Martin-Ansteensen/steppper-robot-arm/images/bearing_2.jpg

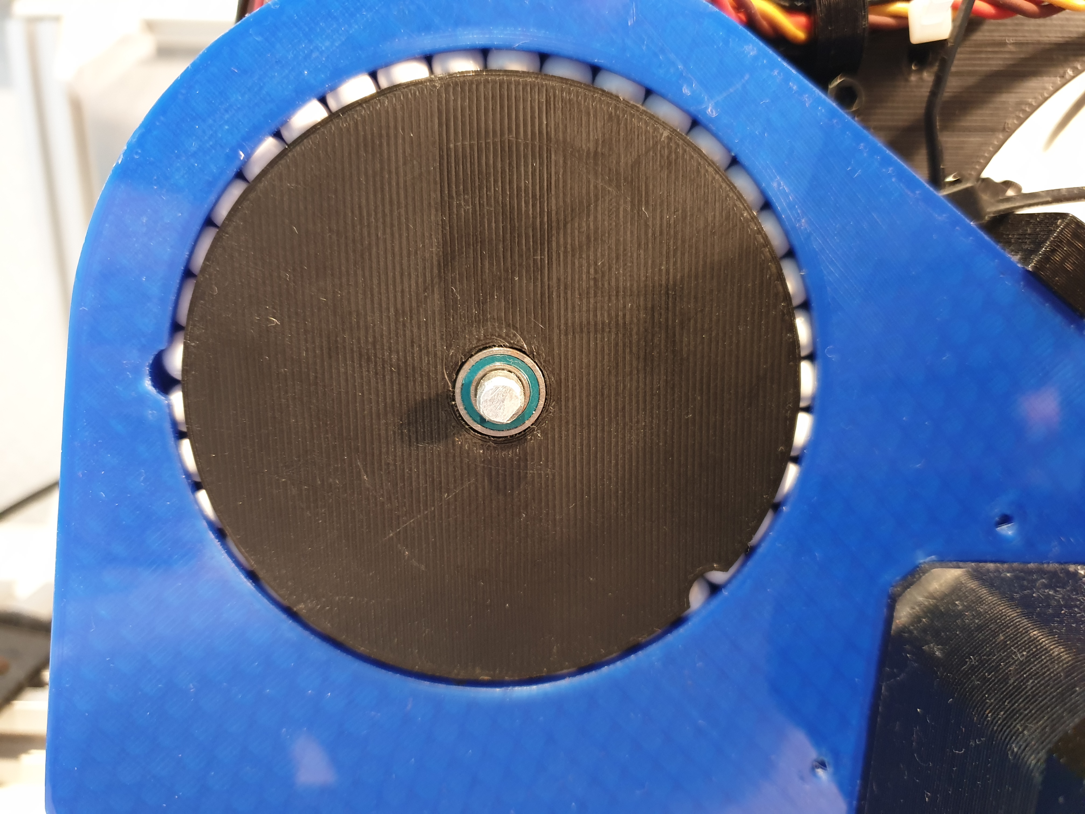
images/bearing_2.jpg
