Martin-Ansteensen/steppper-robot-arm/FinalVersion Drawing v4.pdf

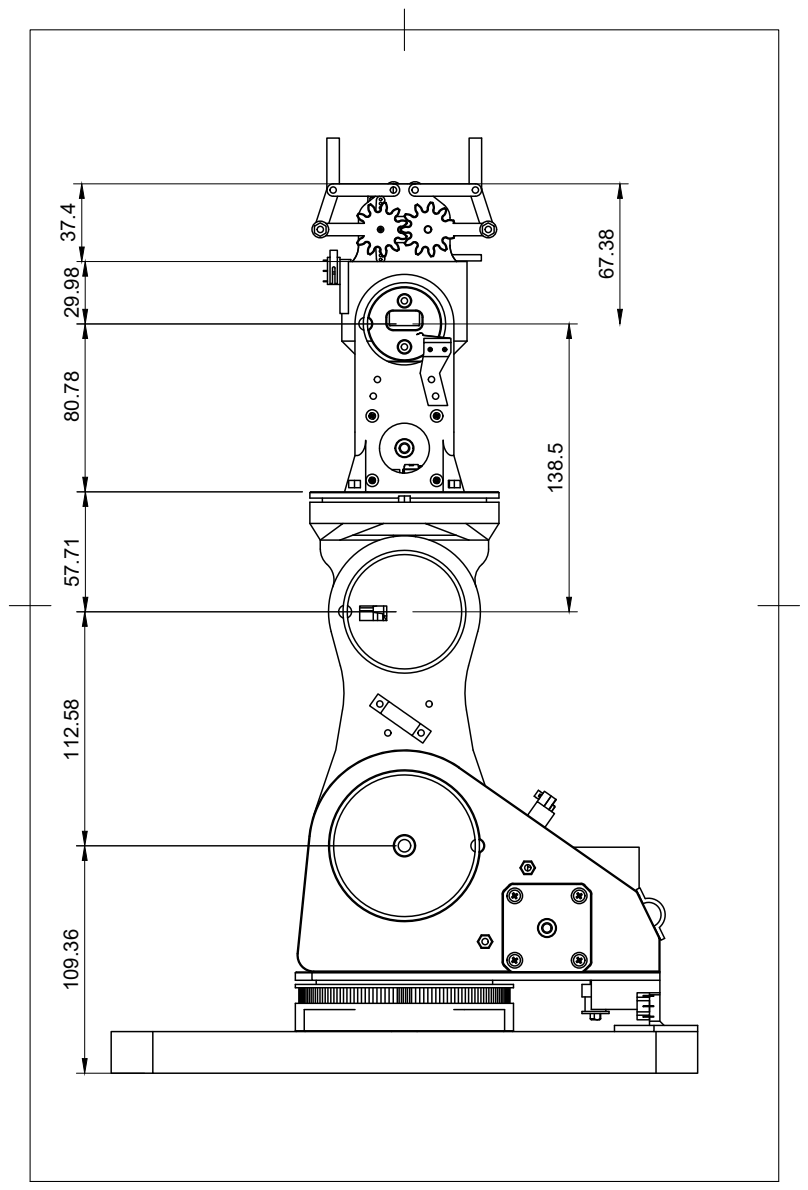
[picture p6: page 1]

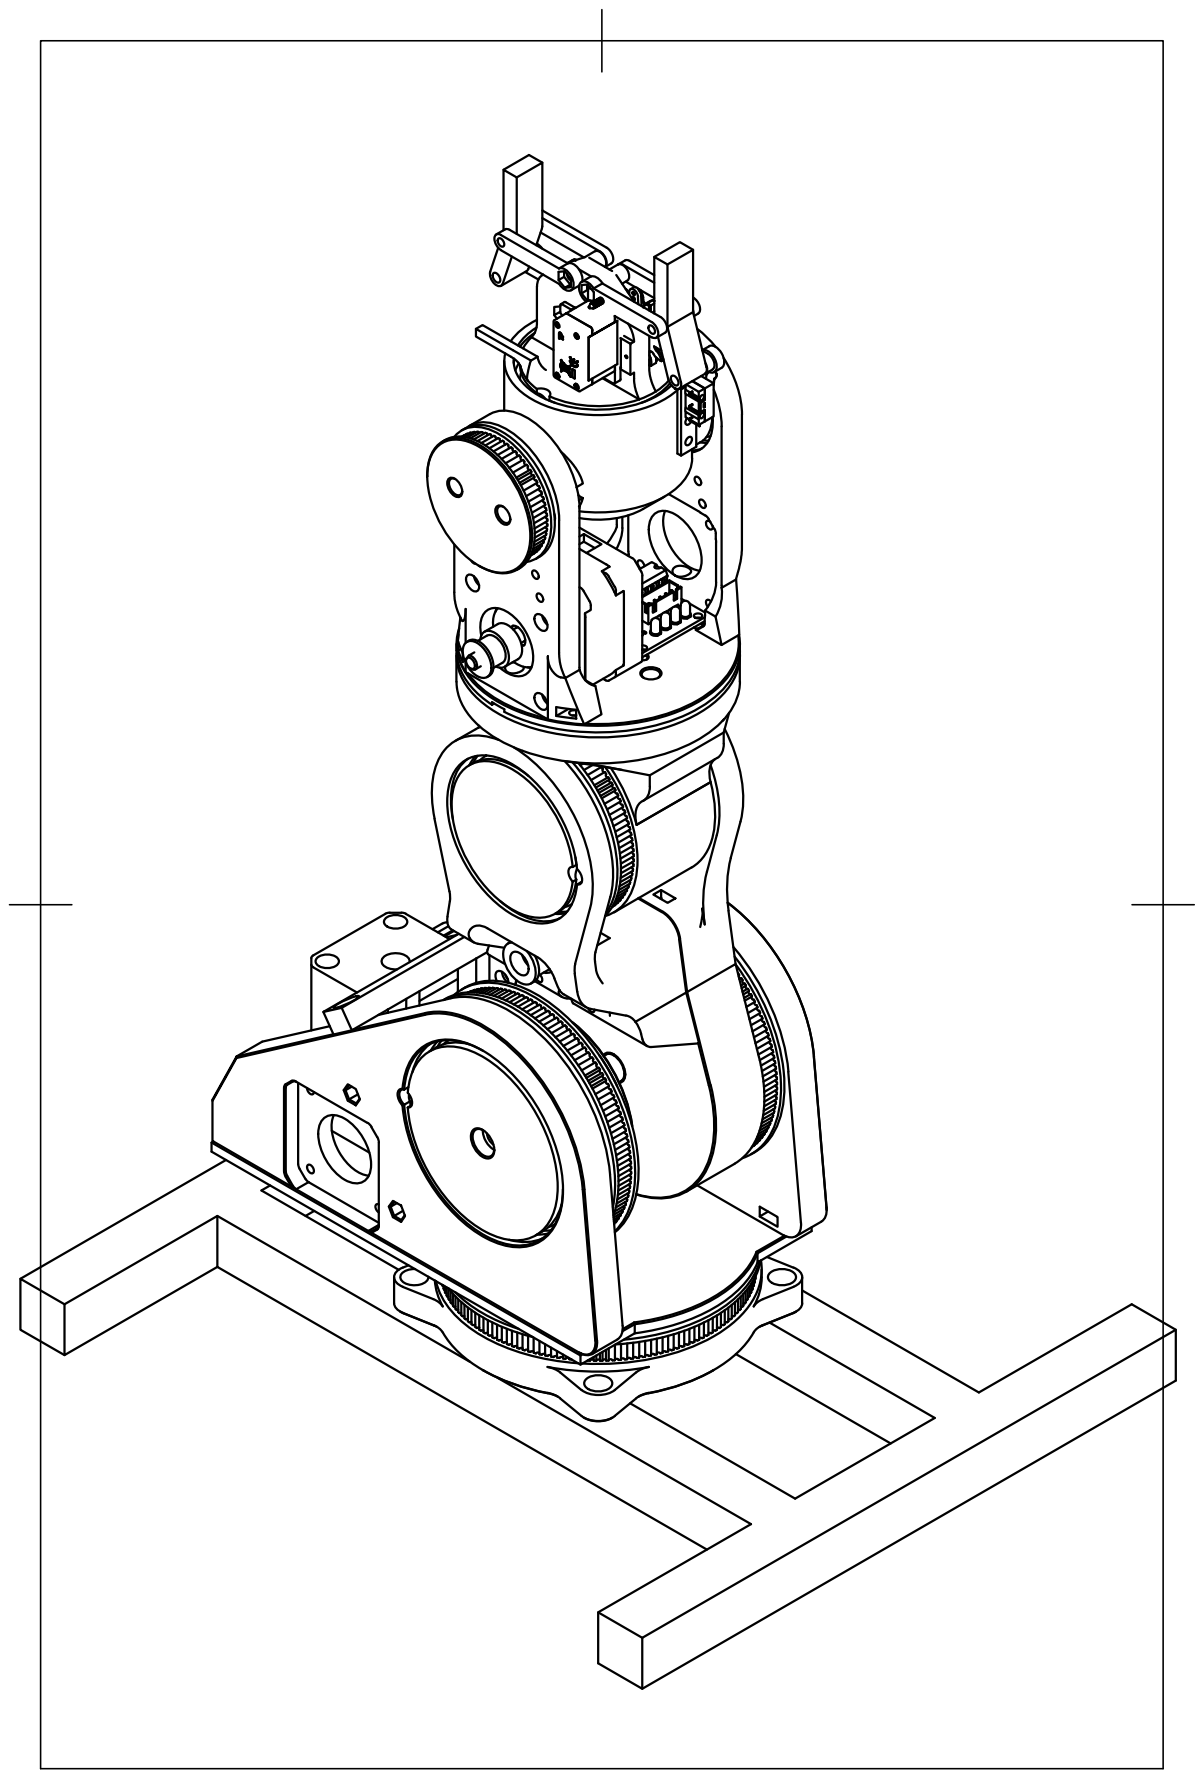
[picture p7: page 2]
