Martin-Ansteensen/steppper-robot-arm/RobotArmDrawing.pdf

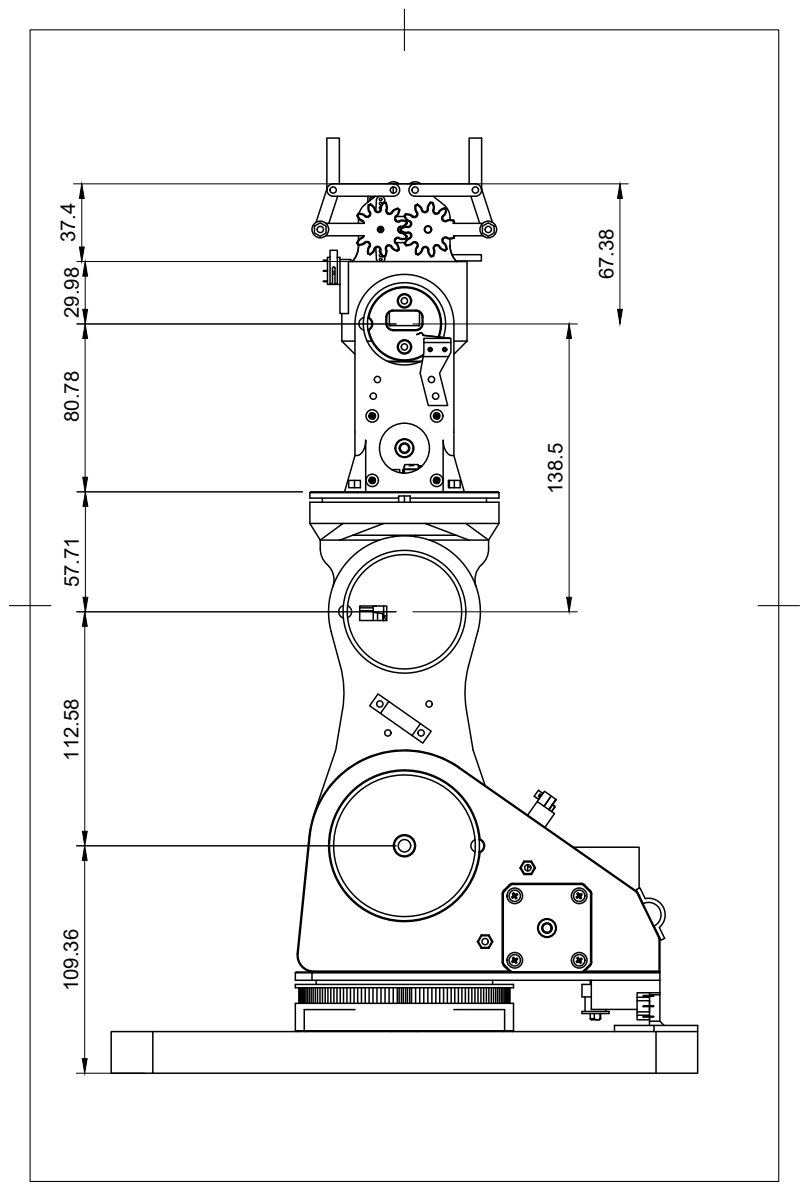
[picture p8: page 1]
