Martin-Ansteensen/steppper-robot-arm/kinematics.py

# /usr/bin/env python3
import math

## NOTE
# Need to do some work on forwardKin in terms of
# validating angles before caculating to avoid
# that the program crash

class Kinematics:
    # A python version of https://github.com/glumb/robot-gui/blob/master/js/Kinematics.js
    def __init__ (self, geometry, joint_limits):
        self.limits = joint_limits
        self.V1_length_x_z = math.sqrt(math.pow(geometry[1][0], 2) + math.pow(geometry[1][2], 2))
        self.V4_length_x_y_z = math.sqrt(math.pow(geometry[4][0], 2) + math.pow(geometry[4][2], 2) + math.pow(-geometry[4][1], 2))

        self.J_initial_absolute = []
        tmpPos = [0, 0, 0]
        for i in range(len(geometry)):
            self.J_initial_absolute.append([tmpPos[0], tmpPos[1], tmpPos[2]])
            tmpPos[0] += geometry[i][0]
            tmpPos[1] += geometry[i][1]
            tmpPos[2] += geometry[i][2]

        self.R_corrected = [0, 0, 0, 0, 0, 0]

        self.R_corrected[1] += math.pi / 2
        self.R_corrected[1] -= math.atan2(geometry[1][0], geometry[1][2]) # correct offset bone

        self.R_corrected[2] += math.pi / 2
        self.R_corrected[2] += math.atan2((geometry[2][2] + geometry[3][2]), (geometry[2][0] + geometry[3][0])) # correct offset bone V2,V3
        self.R_corrected[2] += math.atan2(geometry[1][0], geometry[1][2]) # correct bone offset of V1

        self.R_corrected[4] += math.pi

        self.geometry = geometry

    def inverseKin(self, coords):
        x = coords[0]
        y = coords[1]
        z = coords[2]
        a = coords[3]
        b = coords[4]
        c = coords[5]

        cc = math.cos(c)
        sc = math.sin(c)
        cb = math.cos(b)
        sb = math.sin(b)
        ca = math.cos(a)
        sa = math.sin(a)

        targetVectorZ = [
            sb, -sa * cb,
            ca * cb,
        ]

        R = [
            self.R_corrected[0],
            self.R_corrected[1],
            self.R_corrected[2],
            self.R_corrected[3],
            self.R_corrected[4],
            self.R_corrected[5]
        ]

        J = [
            [0, 0, 0],
            [0, 0, 0],
            [0, 0, 0],
            [0, 0, 0],
            [0, 0, 0],
            [0, 0, 0]
        ]

        # ---- J5 ----
        J[5][0] = x
        J[5][1] = y
        J[5][2] = z

        # ---- J4 ----
        # vector
        J[4][0] = x - self.V4_length_x_y_z * targetVectorZ[0]
        J[4][1] = y - self.V4_length_x_y_z * targetVectorZ[1]
        J[4][2] = z - self.V4_length_x_y_z * targetVectorZ[2]

        # ---- R0 ----
        # # J4
        alphaR0 = math.asin(self.J_initial_absolute[4][1] / self.length2(J[4][1], J[4][0]))
        R[0] += math.atan2(J[4][1], J[4][0])
        R[0] += -alphaR0

        if -1 * self.J_initial_absolute[4][1] > self.length2(J[4][2], J[4][0]):
            print('Kinematics: out of reach')

        # ---- J1 ----
        # # R0
        J[1][0] = math.cos(R[0]) * self.geometry[0][0] + math.sin(R[0]) * -self.geometry[0][1]
        J[1][1] = math.sin(R[0]) * self.geometry[0][0] + math.cos(R[0]) * self.geometry[0][1]
        J[1][2] = self.geometry[0][2]

        # ---- rotate J4 into x,z plane ----
        # J4 R0
        J4_x_z = [0, 0, 0]
        J4_x_z[0] = math.cos(R[0]) * J[4][0] + math.sin(R[0]) * J[4][1]
        J4_x_z[1] = math.sin(R[0]) * J[4][0] + math.cos(R[0]) * -J[4][1] # 0
        J4_x_z[2] = J[4][2]

        # ---- J1J4_projected_length_square ----
        # # J4 R0
        J1J4_projected_length_square = math.pow(J4_x_z[0] - self.J_initial_absolute[1][0], 2) + math.pow(J4_x_z[2] - self.J_initial_absolute[1][2], 2) # not using math.sqrt

        # ---- R2 ----
        # # J4 R0
        J2J4_length_x_z = self.length2(self.geometry[2][0] + self.geometry[3][0], self.geometry[2][2] + self.geometry[3][2])
    
        R[2] += -1.0 * math.acos((-J1J4_projected_length_square + math.pow(J2J4_length_x_z, 2) + math.pow(self.V1_length_x_z, 2)) / (2.0 * (J2J4_length_x_z) * self.V1_length_x_z))
        R[2] -= 2 * math.pi
        R[2] = ((R[2] + 3 * math.pi) % (2 * math.pi)) - math.pi # clamp -180/180 degree

        # ---- R1 ----
        # # J4 R0
        J1J4_projected_length = math.sqrt(J1J4_projected_length_square)
        R[1] -= math.atan2((J4_x_z[2] - self.J_initial_absolute[1][2]), (J4_x_z[0] - self.J_initial_absolute[1][0])) # a''
        R[1] += -1.0 * math.acos((J1J4_projected_length_square - math.pow(J2J4_length_x_z, 2) + math.pow(self.V1_length_x_z, 2)) / (2.0 * J1J4_projected_length * self.V1_length_x_z)) # a
        R[1] = ((R[1] + 3 * math.pi) % (2 * math.pi)) - math.pi

        # ---- J2 ----
        # # R1 R0
        ta = math.cos(R[0])
        tb = math.sin(R[0])
        tc = self.geometry[0][0]
        d = self.geometry[0][2]
        e = -self.geometry[0][1]
        f = math.cos(R[1])
        g = math.sin(R[1])
        h = self.geometry[1][0]
        i = self.geometry[1][2]
        j = -self.geometry[1][1]
        k = math.cos(R[2])
        l = math.sin(R[2])
        m = self.geometry[2][0]
        n = self.geometry[2][2]
        o = -self.geometry[2][1]

        J[2][0] = ta * tc + tb * e + ta * f * h - ta * -g * i + tb * j
        J[2][1] = -(-tb * tc + ta * e - tb * f * h + tb * -g * i + ta * j)
        J[2][2] = d + -g * h + f * i
        
        J[3][0] = J[2][0] + ta * f * k * m - ta * -g * -l * m - ta * -g * k * n - ta * f * -l * n + tb * o
        J[3][1] = J[2][1] - (-tb * f * k * m + tb * -g * -l * m + tb * -g * k * n + tb * f * -l * n + ta * o)
        J[3][2] = J[2][2] + -g * k * m + f * -l * m + f * k * n + g * -l * n

        # ---- J4J3 J4J5 ----
        # # J3 J4 J5
        J4J5_vector = [J[5][0] - J[4][0], J[5][1] - J[4][1], J[5][2] - J[4][2]]
        J4J3_vector = [J[3][0] - J[4][0], J[3][1] - J[4][1], J[3][2] - J[4][2]]

        # ---- R3 ----
        # # J3 J4 J5
        J4J5_J4J3_normal_vector = self.cross(J4J5_vector, J4J3_vector)

        ZY_parallel_aligned_vector = [
            10 * -math.sin(R[0]),
            10 * math.cos(R[0]),
            0
        ]

        ZY_aligned_J4J3_normal_vector = self.cross(ZY_parallel_aligned_vector, J4J3_vector)

        R[3] = self.angleBetween(J4J5_J4J3_normal_vector, ZY_parallel_aligned_vector, ZY_aligned_J4J3_normal_vector)

        R[3] = ((R[3] + 3 * math.pi) % (2 * math.pi)) - math.pi

        # ---- R4 ----
        # # J4 J3 J5 R3
        R[4] += -1 * self.angleBetween2(J4J5_vector, J4J3_vector)
        # clamp -180,180
        R[4] = ((R[4] + 3 * math.pi) % (2 * math.pi)) - math.pi

        # ---- R5 ----
        # # J4 J5 J3
        targetVectorY = [-cb * sc,
            ca * cc - sa * sb * sc,
            sa * cc + ca * sb * sc,
        ]

        R[5] -= self.angleBetween(J4J5_J4J3_normal_vector, targetVectorY, self.cross(targetVectorZ, targetVectorY))
        R[5] = ((R[5] + 3 * math.pi) % (2 * math.pi)) - math.pi

        return R

    def forwardKin(self, angles):
        R0 = angles[0]
        R1 = angles[1]
        R2 = angles[2]
        R3 = angles[3]
        R4 = angles[4]
        R5 = angles[5]

        a = math.cos(R0)
        b = math.sin(R0)
        c = self.geometry[0][0]
        d = self.geometry[0][1]
        e = self.geometry[0][2]
        f = math.cos(R1)
        g = math.sin(R1)
        h = self.geometry[1][0]
        i = self.geometry[1][1]
        j = self.geometry[1][2]
        k = math.cos(R2)
        l = math.sin(R2)
        m = self.geometry[2][0]
        n = self.geometry[2][1]
        o = self.geometry[2][2]
        p = math.cos(R3)
        q = math.sin(R3)
        r = self.geometry[3][0]
        s = self.geometry[3][1]
        t = self.geometry[3][2]
        u = math.cos(R4)
        v = math.sin(R4)
        w = self.geometry[4][0]
        x = self.geometry[4][1]
        y = self.geometry[4][2]
        A = math.cos(R5)
        B = math.sin(R5)
    
        jointsResult = [[0,0,0], [0,0,0], [0,0,0], [0,0,0], [0,0,0], [0,0,0,0,0,0]]


        jointsResult[0][0] = 0
        jointsResult[0][1] = 0
        jointsResult[0][2] = 0

        jointsResult[1][0] = jointsResult[0][0] + a * c - b * d
        jointsResult[1][1] = jointsResult[0][1] + b * c + a * d
        jointsResult[1][2] = jointsResult[0][2] + e

        jointsResult[2][0] = jointsResult[1][0] + a * f * h - b * i + a * g * j
        jointsResult[2][1] = jointsResult[1][1] + b * f * h + a * i + b * g * j
        jointsResult[2][2] = jointsResult[1][2] + -g * h + f * j

        jointsResult[3][0] = jointsResult[2][0] + a * f * k * m - a * g * l * m - b * n + a * g * k * o + a * f * l * o
        jointsResult[3][1] = jointsResult[2][1] + b * f * k * m - b * g * l * m + a * n + b * g * k * o + b * f * l * o
        jointsResult[3][2] = jointsResult[2][2] - g * k * m - f * l * m + f * k * o - g * l * o

        jointsResult[4][0] = jointsResult[3][0] + a * f * k * r - a * g * l * r - b * p * s + a * g * k * q * s + a * f * l * q * s + a * g * k * p * t + a * f * l * p * t + b * q * t
        jointsResult[4][1] = jointsResult[3][1] + b * f * k * r - b * g * l * r + a * p * s + b * g * k * q * s + b * f * l * q * s + b * g * k * p * t + b * f * l * p * t - a * q * t
        jointsResult[4][2] = jointsResult[3][2] - g * k * r - f * l * r + f * k * q * s - g * l * q * s + f * k * p * t - g * l * p * t

        jointsResult[5][0] = jointsResult[4][0] + a * f * k * u * w - a * g * l * u * w - a * g * k * p * v * w - a * f * l * p * v * w - b * q * v * w - b * p * x + a * g * k * q * x + a * f * l * q * x + a * g * k * p * u * y + a * f * l * p * u * y + b * q * u * y + a * f * k * v * y - a * g * l * v * y
        jointsResult[5][1] = jointsResult[4][1] + b * f * k * u * w - b * g * l * u * w - b * g * k * p * v * w - b * f * l * p * v * w + a * q * v * w + a * p * x + b * g * k * q * x + b * f * l * q * x + b * g * k * p * u * y + b * f * l * p * u * y - a * q * u * y + b * f * k * v * y - b * g * l * v * y
        jointsResult[5][2] = jointsResult[4][2] - g * k * u * w - f * l * u * w - f * k * p * v * w + g * l * p * v * w + f * k * q * x - g * l * q * x + f * k * p * u * y - g * l * p * u * y - g * k * v * y - f * l * v * y

        M = [
            [-B * b * p + B * a * g * k * q + B * a * f * l * q - A * a * g * k * p * u - A * a * f * l * p * u - A * b * q * u - A * a * f * k * v + A * a * g * l * v, -A * b * p + A * a * g * k * q + A * a * f * l * q + B * a * g * k * p * u + B * a * f * l * p * u + B * b * q * u + B * a * f * k * v - B * a * g * l * v, a * f * k * u - a * g * l * u - a * g * k * p * v - a * f * l * p * v - b * q * v],
            [B * a * p + B * b * g * k * q + B * b * f * l * q - A * b * g * k * p * u - A * b * f * l * p * u + A * a * q * u - A * b * f * k * v + A * b * g * l * v, A * a * p + A * b * g * k * q + A * b * f * l * q + B * b * g * k * p * u + B * b * f * l * p * u - B * a * q * u + B * b * f * k * v - B * b * g * l * v, b * f * k * u - b * g * l * u - b * g * k * p * v - b * f * l * p * v + a * q * v],
            [B * f * k * q - B * g * l * q - A * f * k * p * u + A * g * l * p * u + A * g * k * v + A * f * l * v, A * f * k * q - A * g * l * q + B * f * k * p * u - B * g * l * p * u - B * g * k * v - B * f * l * v, -g * k * u - f * l * u - f * k * p * v + g * l * p * v]
            ]

        # https:#www.geometrictools.com/Documentation/EulerAngles.pdf
        thetaY = 0
        thetaX = 0
        thetaZ = 0
        if M[0][2] < 1:
            if M[0][2] > -1:
                thetaY = math.asin(M[0][2])
                thetaX = math.atan2(-M[1][2], M[2][2])
                thetaZ = math.atan2(-M[0][1], M[0][0])
            else:
                thetaY = -math.pi / 2
                thetaX = -math.atan2(M[1][0], M[1][1])
                thetaZ = 0
        else:
            thetaY = +math.pi / 2
            thetaX = math.atan2(M[1][0], M[1][1])
            thetaZ = 0


        jointsResult[5][3] = thetaX
        jointsResult[5][4] = thetaY
        jointsResult[5][5] = thetaZ
        return jointsResult

    def cross(self, vectorA, vectorB):
        result = [0, 0, 0]
        result[0] = vectorA[1] * vectorB[2] - vectorA[2] * vectorB[1]
        result[1] = vectorA[2] * vectorB[0] - vectorA[0] * vectorB[2]
        result[2] = vectorA[0] * vectorB[1] - vectorA[1] * vectorB[0]
        return result

    def dot(self, vectorA, vectorB):
        return vectorA[0] * vectorB[0] + vectorA[1] * vectorB[1] + vectorA[2] * vectorB[2]

    def angleBetween(self, vectorA, vectorB, referenceVector):

        norm = self.length3(self.cross(vectorA, vectorB))

        angle = math.atan2(norm, (vectorB[0] * vectorA[0] + vectorB[1] * vectorA[1] + vectorB[2] * vectorA[2]))

        tmp = referenceVector[0] * vectorA[0] + referenceVector[1] * vectorA[1] + referenceVector[2] * vectorA[2]
        if tmp > 0.0001:
            sign = 1.0
        else:
            sign = -1.0
        return angle * sign

    def length3(self, vector):
        return math.sqrt(math.pow(vector[0], 2) + math.pow(vector[1], 2) + math.pow(vector[2], 2))

    def length2(self, a, b):
        return math.sqrt(math.pow(a, 2) + math.pow(b, 2))

    def angleBetween2(self, v1, v2):
        angle = 0
        cross = self.cross(v1, v2)
        return math.atan2(self.length3(cross), self.dot(v1, v2))

    def convertRadToDeg(self, angles):
        for i in range(len(angles)):
            angles[i] = angles[i]*180/math.pi 
        return angles
    
    def validateRobotAnglesDeg(self, angles):
        print("Kinematics: angles in deg ", angles)
        for i, angle in enumerate(angles):
            if self.limits[i][0] <= angle <= self.limits[i][1]:
                pass
            else:
                # Invalid angle, abort process
                print("Kinematics: Angles exceed the robot's limits")
                return False
        # All angles are valid, continue
        print("Kinematics: Angles are valid")
        return True

    def doInverseKin(self, coordinates):
        try:
            return self.inverseKin(coordinates)
        except ValueError as e:
            print("Kinematics: ", e)
            print("Kinematics: The destination is out of reach for the robot")
            return False  

    def map(self, x, in_min, in_max, out_min, out_max):
	    return (x - in_min) * (out_max - out_min) / (in_max - in_min) + out_min
       
    def calculate_gripper_angle(self, width):
        """ Takes the width of an object and
        returns the angle of the servo motor 
        controlling the gripper that matches
        this width """
        angle = math.acos(width/60)*180/math.pi
        angle = self.map(angle, 0, 90, 0, 180)

if __name__ == "__main__":

    geo = [
        #xyz
        [0,0,109.4], # V0
        [0,0,112.6], # V1
        [57.7,0,0],  # V2
        [80.8,0,0],  # V3
        [67.4,0,0]   # V4
    ]


    joint_limits = [
        [-90, 190],
        [-42, 110],
        [-180, 2],
        [0, 180],
        [-102, 102],
        [-90, 240],
        [0, 180]
    ]

    robot = Kinematics(geo, joint_limits)
    pos = [14, -8.1, 13.4, -3.14,  0,  -1.27]
    angles_rad = robot.doInverseKin([500, 20, 100, -math.pi, 0, -1])
    if angles_rad:
        angles_deg = robot.convertRadToDeg(angles_rad)
        robot.validateRobotAnglesDeg(angles_deg)
        print("Kinematics: angles in deg ", angles_deg)
