Martin-Ansteensen/steppper-robot-arm/(commit log)

2021-06-18 Update kinematics.py
    New version of kinematics added
2021-06-20 Create robotArm.ino
    First version of the program that controls the motors. Currently supports commands from Serial, moving all joints at the same time, homing with endstops and to some degree interpolation
2021-08-28 Update robotArm.ino
    Fixed bug regarding movement of servos in MoveJoints
    [robotArm.ino]
2021-08-28 A rasberry pi can now control the arduino trough serial
2021-09-04 Added new files and updated kinematics
2021-09-05 The kinematics model can now interact with the control program. The arduino program has been changed to match the robot controller. Still need to validate coordinates before sending them to the robot
2021-09-19 First working version with camera detection of objects. Lots of bugs. Need to fix servo movement in the arduino code (when giving the same angle with MoveJoints the claw opens)
    [control.py, kinematics.py]
2021-09-19 Fixed gripper issue
2021-10-06 First fully working version of the software. The code has been cleaned up, and robot arm can now pick up round objects, and the object detection is displayed in its own window. You can also have the 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
2021-10-10 Fixed bug that caaused servos to halt the program if the travel distance for the servo was very small
    [robotArm.ino]
2021-10-10 Added new functionality to let the user choose what mode the arm should be in via the console
